kd4gar/ReelClock/(commit log)

2026-09-29 Initial commit: ESP32 Bally EM score-reel clock
    Self-homing 4-reel clock (H:MM) driven by score-reel solenoids, an ESP32,
    and a relay board. NTP time sync with automatic DST, per-reel bench-tuned
    pulse timing, and a ground-truth drift self-correction check against each
    reel's zero switch.
    Fill in WIFI_SSID / WIFI_PASSWORD and GMT/TZ settings for your own network
    before flashing.
    [ReelClock.ino]
2026-09-29 Add wiring schematic PDF
